zhangjinke/can_gateway_4_hdk/BOM.xls

Comment | Description | Designator | Footprint | LibRef | Quantity
0Ω | Resistor | R41 | RESC1608L | Res1 | 1
0.1uF | Capacitor | C72, C90 | CAPC2012L | Cap1 | 2
0.1uF | Capacitor | C82 | CAPC1608L | Cap1 | 1
0.5A 6V | Fuse | F1 | FUSE2012L | Fuse 2 | 1
1MR | Resistor | R17, R18, R19, R20 | RESC3216L | Res1 | 4
1nF/2kV | Capacitor | C34, C35, C36, C37 | CAPC3216L | Cap1 | 4
1uF | Capacitor | C1, C14, C15, C16, C17, C58, C59, C60, C67, C70, C81, C83, C94 | CAPC1608L | Cap1 | 13
1.5K | Resistor | R24 | RESC1608L | Res1 | 1
2K | Resistor | R45, R47 | RESC1608L | Res1 | 2
2.7R | Resistor | R9, R10, R11, R12, R13, R14, R15, R16 | RESC3216L | Res1 | 8
4.7uF | Capacitor | C22, C23, C24, C25 | CAPC2012L | Cap1 | 4
4.7uF | Capacitor | C69 | CAPC3216L | Cap1 | 1
6K | Resistor | R2 | RESC1608L | Res1 | 1
6pF | Capacitor | C2, C3, C4, C5, C6, C7, C8, C9, C10, C11, C12, C13 | CAPC1608L | Cap1 | 12
8.2K | Resistor | R44 | RESC1608L | Res1 | 1
10M | Resistor | R4 | RESC1608L | Res1 | 1
10pF | Capacitor | C39, C40, C41, C42 | CAPC1608L | Cap1 | 4
10uF | Capacitor | C26, C27, C28, C29 | CAPC2012L | Cap1 | 4
10uF | Capacitor | C44, C45, C46, C47, C48, C53, C54, C55, C56, C57, C65, C78, C79, C84, C87, C91 | CAPC1608L | Cap1 | 16
18pF | Capacitor | C50, C51, C52 | CAPC1608L | Cap1 | 3
22nF | Capacitor | C38 | CAPC1608L | Cap1 | 1
22uF | Capacitor | C88 | CAPC3216L | Cap1 | 1
24MHz | Crystal Oscillator | Y1, Y3, Y4, Y5, Y6 | XTAL-3225 | XTAL_PASSIVE_4 | 5
43K | Resistor | R43 | RESC1608L | Res1 | 1
47K | Resistor | R1, R5, R6, R7, R8 | RESC1608L | Res1 | 5
56K | Resistor | R21 | RESC1005L | Res1 | 1
100K | Resistor | R39, R42 | RESC1608L | Res1 | 2
100nF | Capacitor | C18, C19, C20, C21, C30, C31, C32, C33, C43, C49, C61, C62, C63, C64, C66, C68, C71, C73, C74, C75, C76, C77, C80, C85, C86, C89, C92, C93 | CAPC1608L | Cap1 | 28
110R | Resistor | R26, R28, R30, R32, R34 | RESC1608L | Res1 | 5
150K | Resistor | R35, R38, R40 | RESC1608L | Res1 | 3
200K | Resistor | R36, R46 | RESC1608L | Res1 | 2
240Ω | Resistor | R3 | RESC1608L | Res1 | 1
270R | Resistor | R25, R27, R29, R31, R33 | RESC1608L | Res1 | 5
510R | Resistor | R22, R23 | RESC1608L | Res1 | 2
680K | Resistor | R37 | RESC1608L | Res1 | 1
ADUM1201ARZ | 双通道数字隔离器（1/1通道方向性） | U7, U9, U11, U13 | SOIC8_L | ADUM1201 | 4
B340A-E3-61T | Schottky Diode | D15 | DO-214AC | D Schottky | 1
B82793S0513N201 | 共模电感 | L1, L2, L3, L4 | IND0163-B | Inductor1 | 4
B_S-1WR2 | DC/DC 模块电源 1W，定电压输入，隔离非稳压单路输出 | U6, U8, U10, U12 | B_S-1WR2 | B_S-1WR2 | 4
CDRH74R 10uH | Inductor | L8 | IND_7545 | Inductor | 1
EA3036 |  | U24 | QFN20_L | EA3036 | 1
Header 3 | Header, 3-Pin | P1, P2, P3, P4, P6 | KF2EDGR-5.08-3P_S | Header 3 | 5
Header 4 | Header, 4-Pin | P5 | HDR1X4 | Header 4 | 1
HR911105A |  | EARTHNET1 | HR911105A | HR911105A | 1
LED1 | Typical RED GaAs LED | D9 | LED_3 | LED1 | 1
LEDx2_CA | 共阳红绿双色二极管 | D10, D11, D12, D13, D14 | LED_3x2 | LEDx2_CA | 5
M |  | M1, M2 | M3 | M | 2
MC-146 | Crystal Oscillator | Y2 | MC-146 | XTAL | 1
MCP2515-I/SO | Stand-Alone CAN Controller With SPI Interface, 18-Pin SOIC, Industrial Temperature | U2, U3, U4, U5 | SOIC18_N | MCP2515-I/SO | 4
MP2359 | 1.2A, 24V, 1.4MHz异步降压转换器 | U26 | SOT23-6_L | MP2359 | 1
SD NAND | 贴片式SD卡 | U22 | QFN8_L | SD NAND | 1
SM712 |  | U18, U19, U20, U21 | SOT23_L | Tranzorb2 | 4
SMBJ5.0A | Transient Voltage Suppression (TVS) Diode | D1, D2, D3, D4, D5, D6, D7, D8 | DO-214AA | Tranzorb1 | 8
SRV05-4 |  | U23 | SOT23-6_L | NUP4201 | 1
SWPA3012S2R2MT | Inductor | L5, L6, L7 | IND3012_L | Inductor | 3
SW-PB | Switch | S1 | SW_4.5x3.8 | SW-PB | 1
SW-PB | Switch | S2 | SW-3x6 | SW-PB | 1
TEST_POINT | 测试点 | T1, T2, T3, T4, T5, T6, T7, T8, T9, T10 | TEST_POINT_0.8 | TEST_POINT | 10
TJA1042T | 具有待机模式的高速CAN收发器 | U14, U15, U16, U17 | SOIC8_L | TJA1042T | 4
USB_TYPE_C_16P |  | J1 | USB_TYPEC_16P | USB_TYPE_C_16P | 1
V3S | 全志 ARM Cortex-A7 SoC，内置64MB DDR2 | U1 | V3S_L | V3S | 1
XC6206 |  | U25 | SOT23_L | LDO-SOT23-3 | 1
