zhangjinke/can_gateway_4_hdk/can_gateway_4.pdf

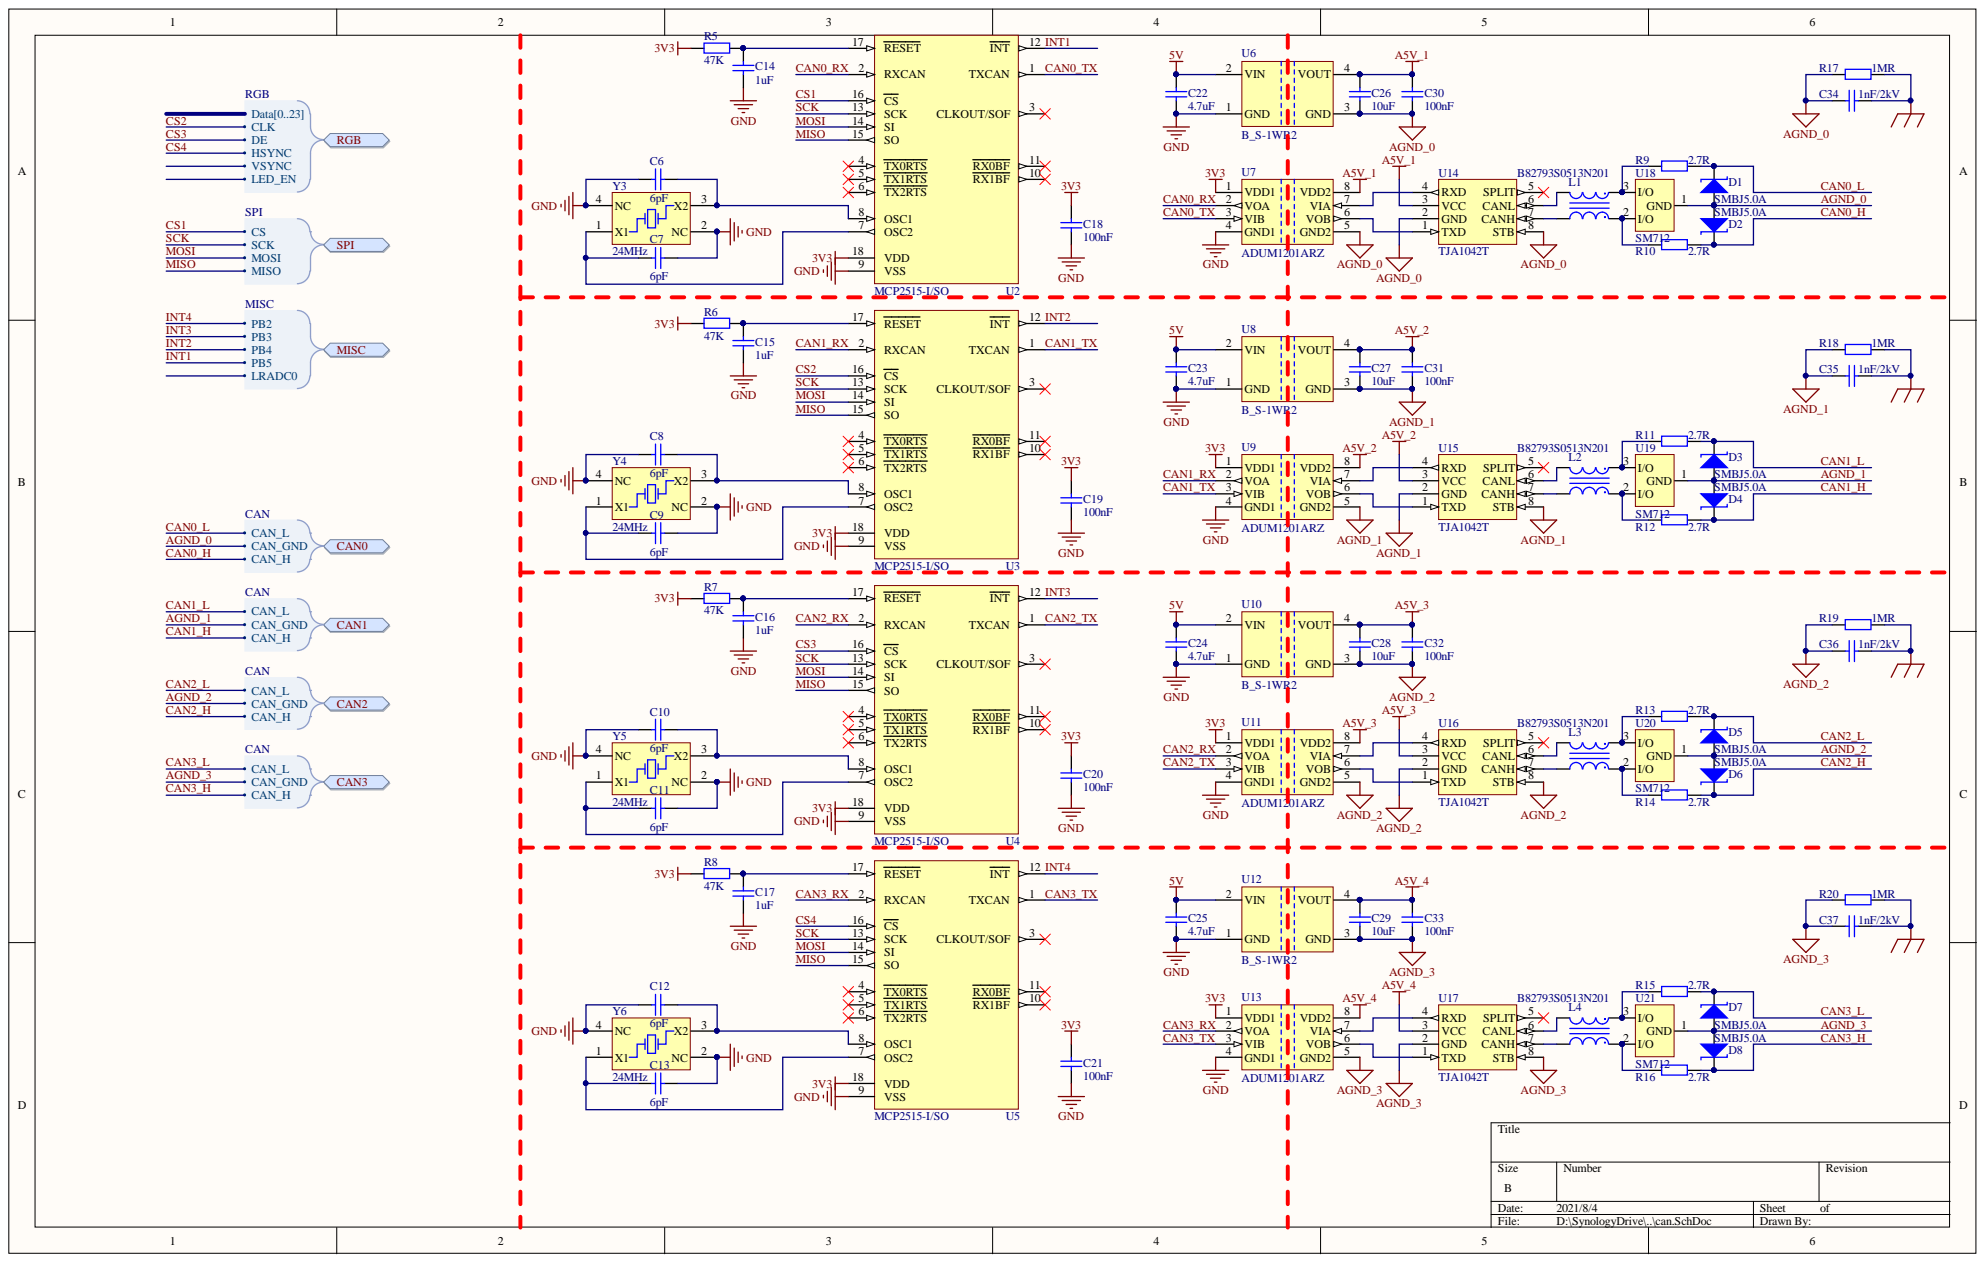
[picture p1: page 1]

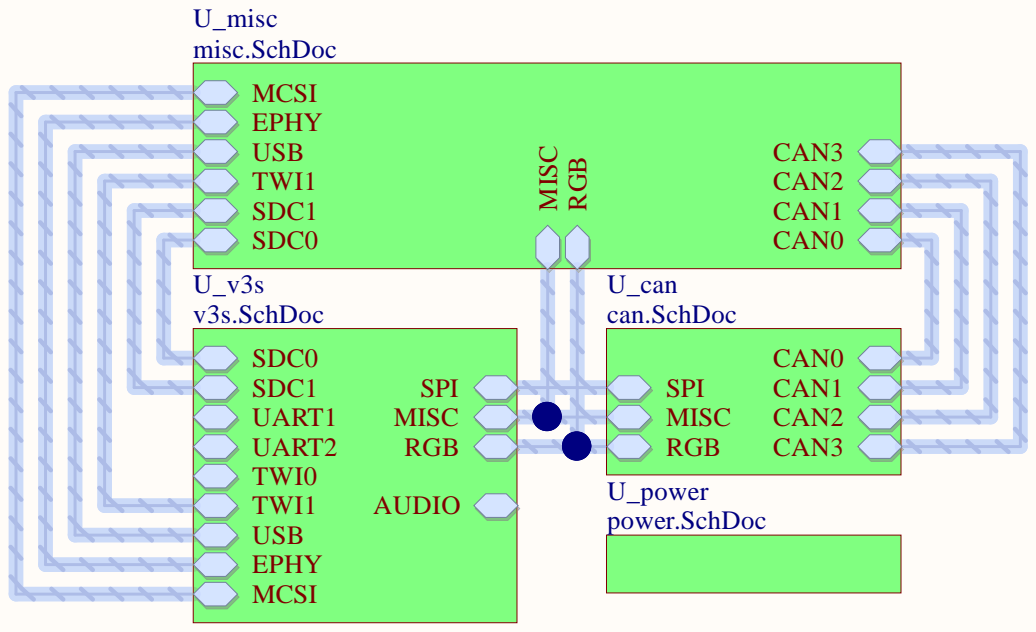
[picture p2: page 2]

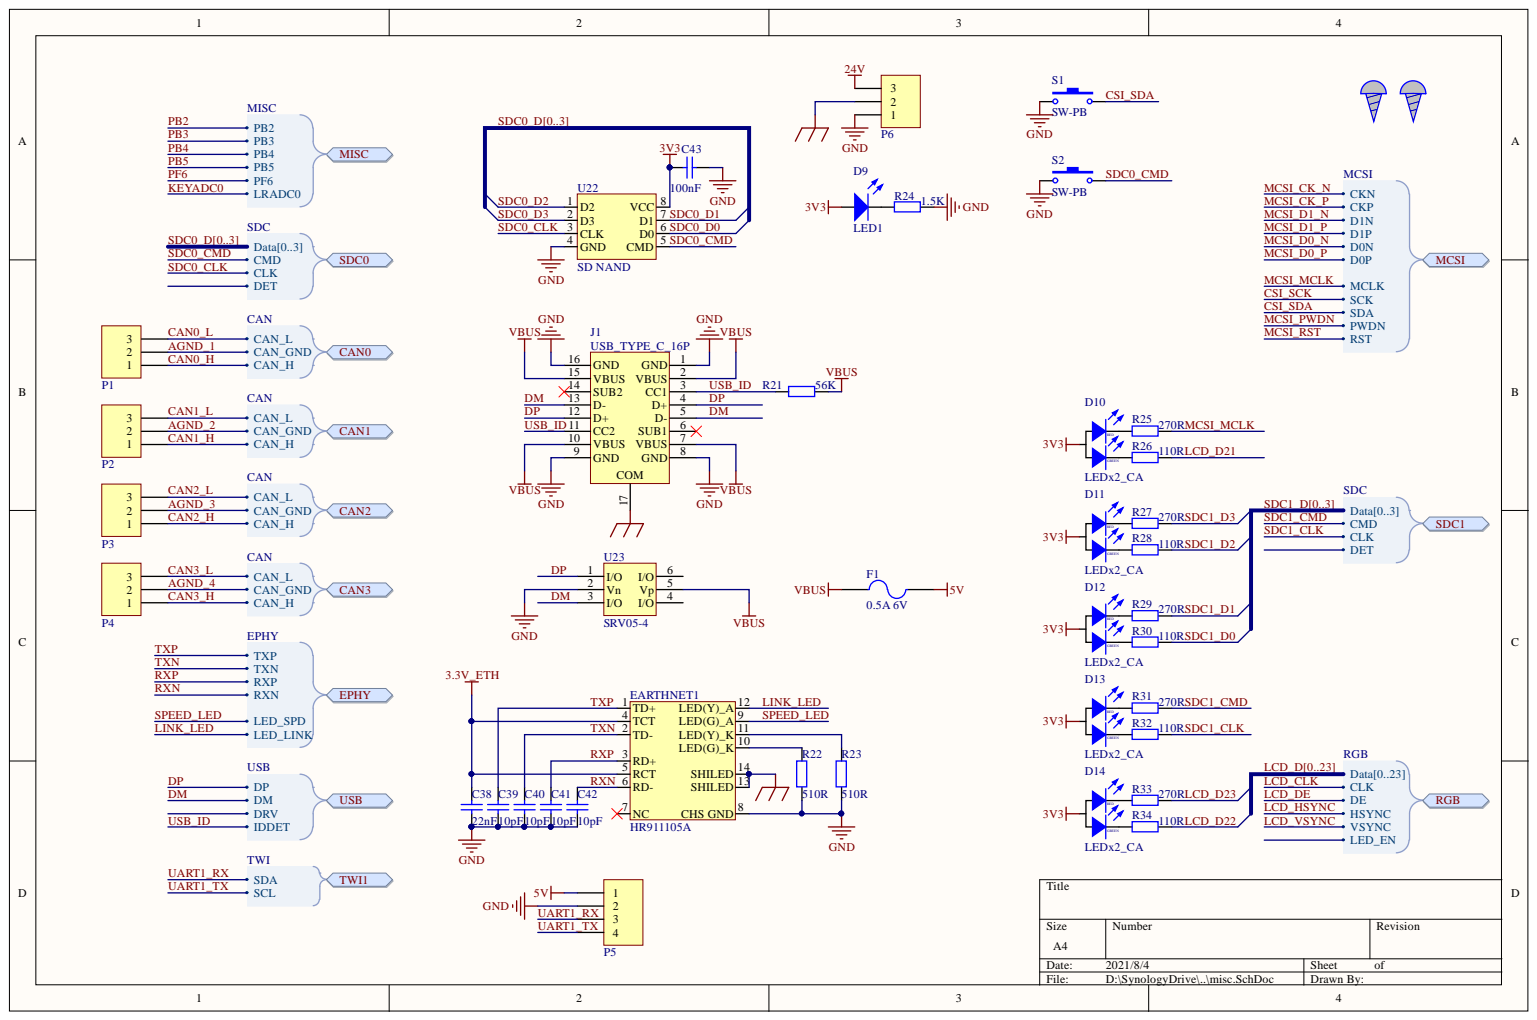
[picture p3: page 3]

TCT 4
TXN | | TD- 2

RXP | | RD+ 3
RCT 5

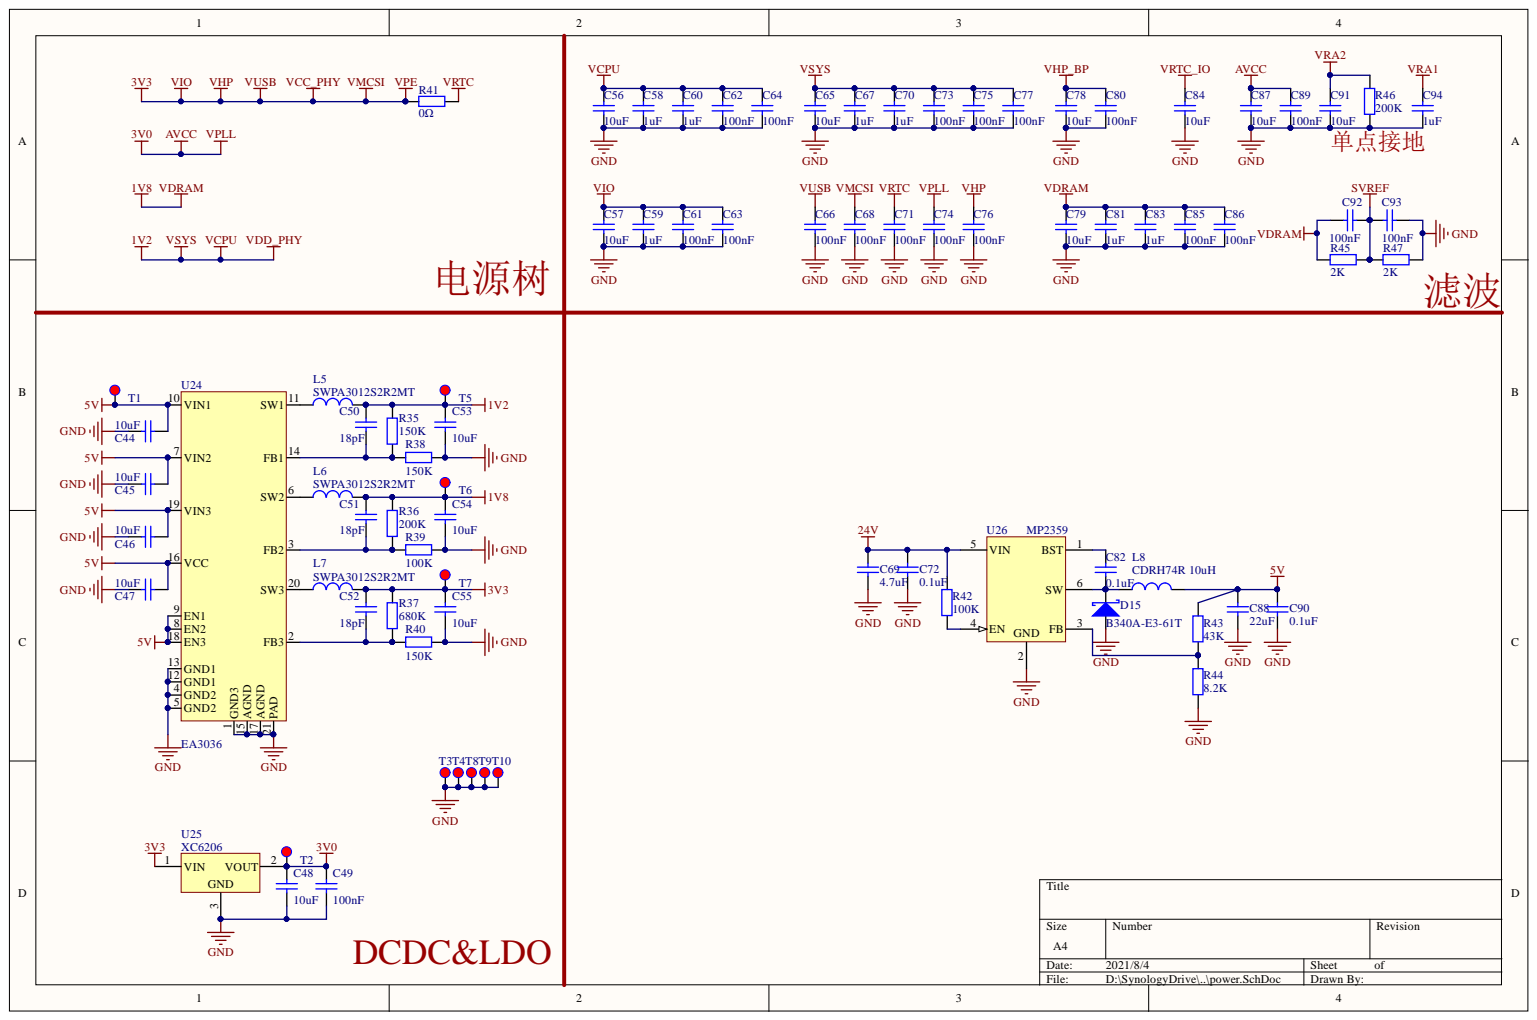
[picture p4: page 4]

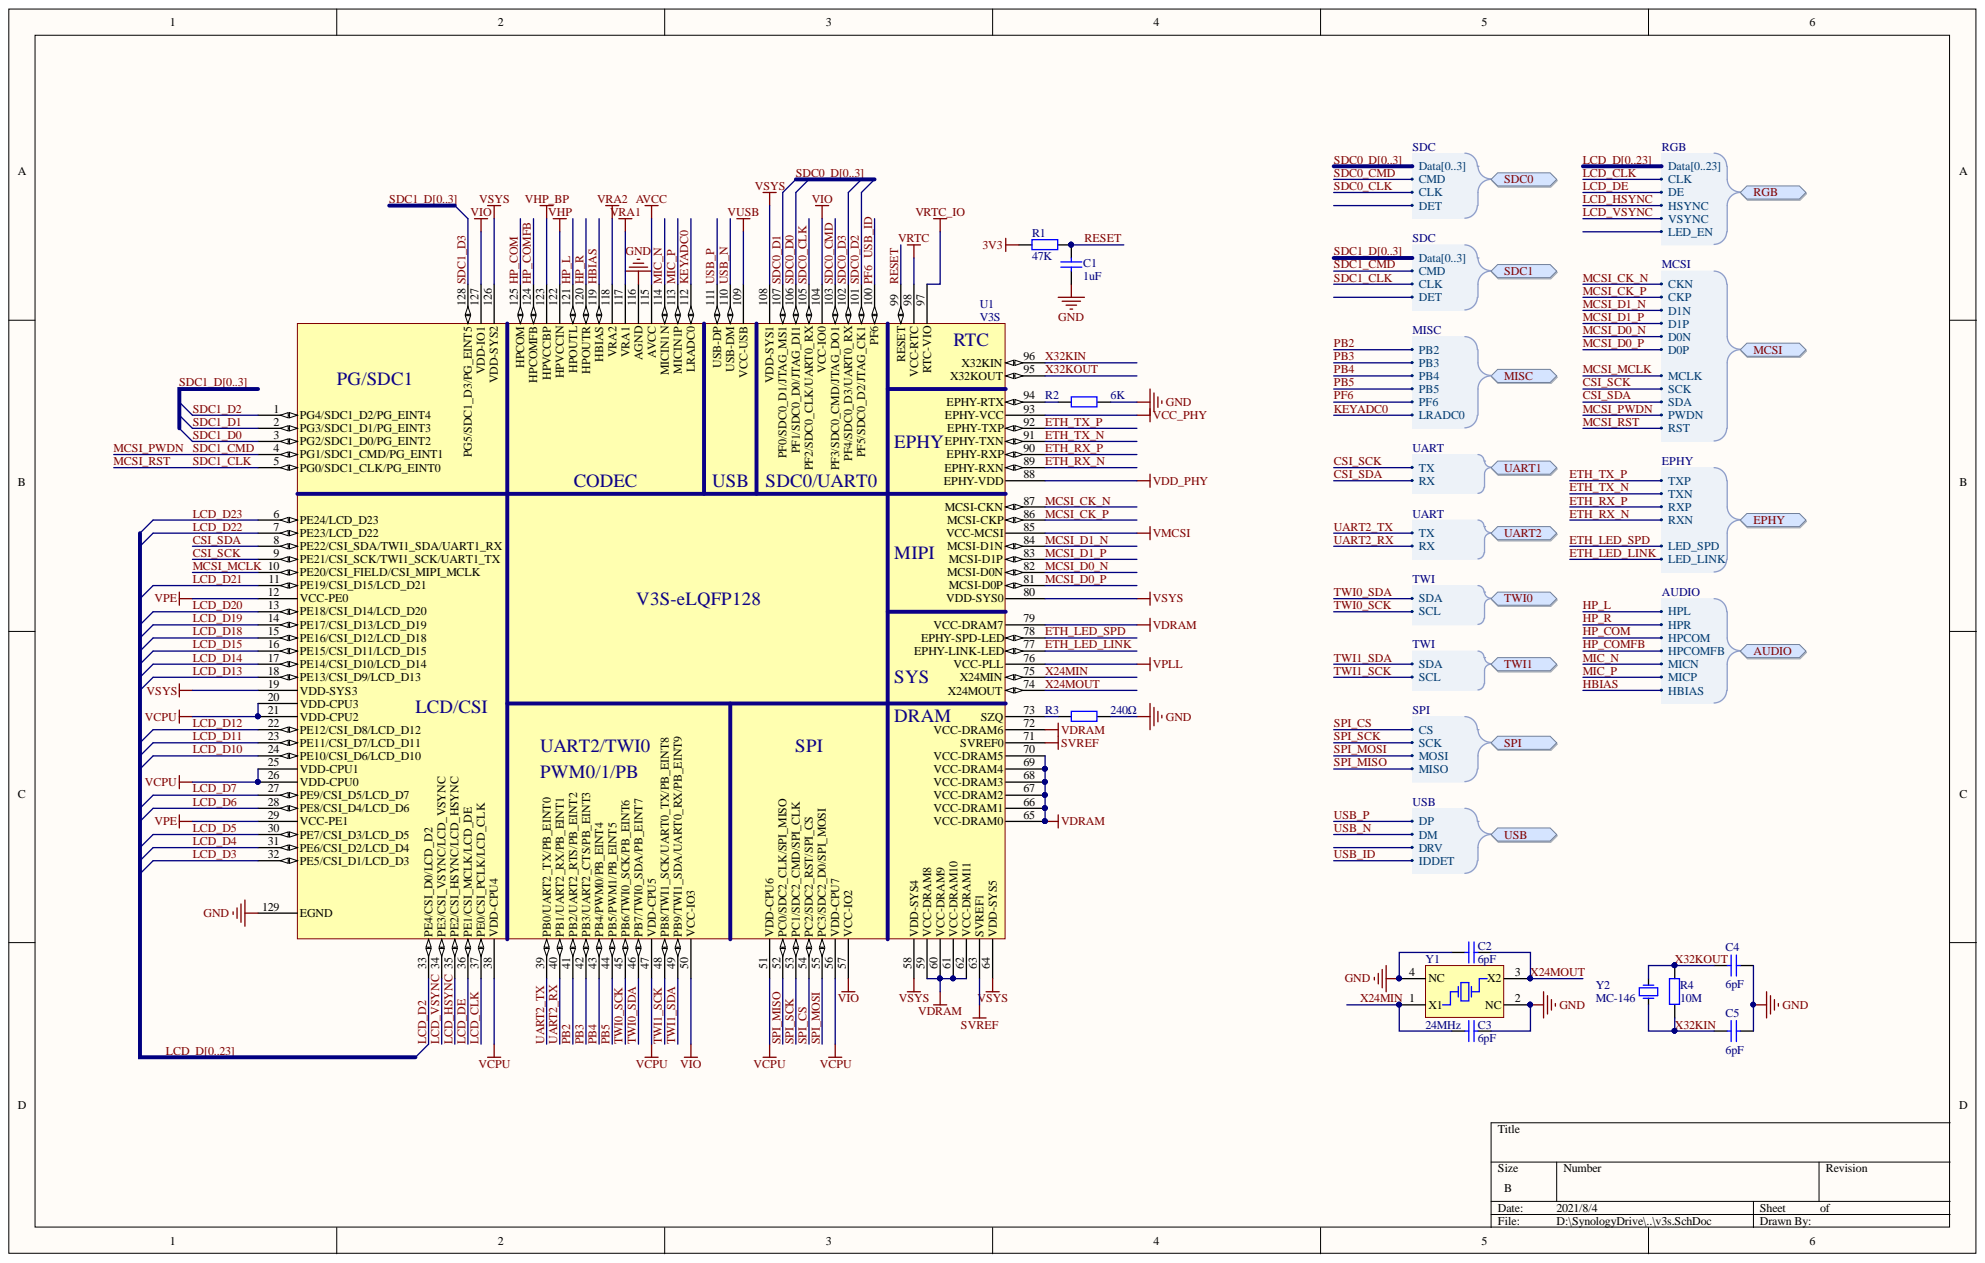
[picture p5: page 5]

LRADC0 112 MICIN1P 113 MICIN1N 114 AVCC 115 AGND 116 VRA1 117 VRA2 118 HBIAS 119 HPOUTR 120 HPOUTL 121 HPVCCIN 122 HPVCCBP 123 HPCOMFB 124 HPCOM 125

VCC-USB 109 USB-DM 110 USB-DP 111

RTC-VIO 97 VCC-RTC 98 RESET 99
