zhangjinke/can_gateway_4_hdk/(list of files, drawings)

Other design files:
can.SchDoc
can_gateway_4.PrjPcb
can_gateway_4.SchDoc
misc.SchDoc
power.SchDoc
v3s.SchDoc
