zhangjinke/can_gateway_4_hdk/(commit log)

2020-09-22 更新LED限流电阻值，添加pdf版原理图
    [can_gateway_v3s_hardwave.xls, misc.SchDoc]
2020-12-03 修改调试串口为UART0，修正USB_ID未连接的问题
    [can_gateway_v3s_hardwave.PrjPcb, can_gateway_v3s_hardwave.SchDoc, can_gateway_v3s_hardwave.xls, misc.SchDoc, v3s.SchDoc]
2021-08-04 添加FEL按键
    [can_gateway_v3s_hardwave.PrjPcb, misc.SchDoc]
2021-08-04 重命名为can_gateway_4，版本号升级为V1.0
    [BOM.xls, can.SchDoc, can_gateway_4.PrjPcb, can_gateway_4.SchDoc, can_gateway_v3s_hardwave.PrjPcb, can_gateway_v3s_hardwave.SchDoc, can_gateway_v3s_hardwave.xls, misc.SchDoc]
